jayanth-rajakumar/ledmat/docs/thumb_tutorial.png

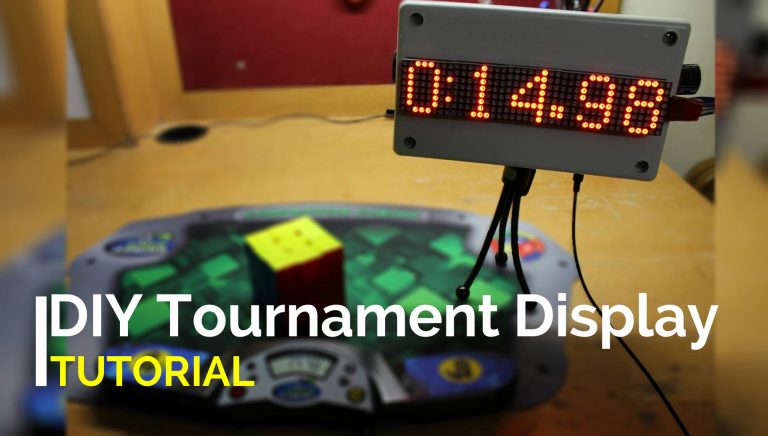
docs/thumb_tutorial.png
