jayanth-rajakumar/ledmat/docs/coverphoto.jpg

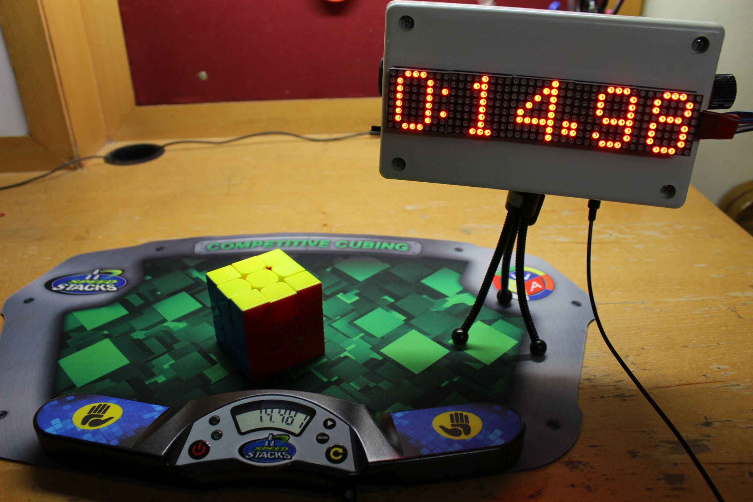
docs/coverphoto.jpg
