jayanth-rajakumar/ledmat/docs/blockdiagram.png

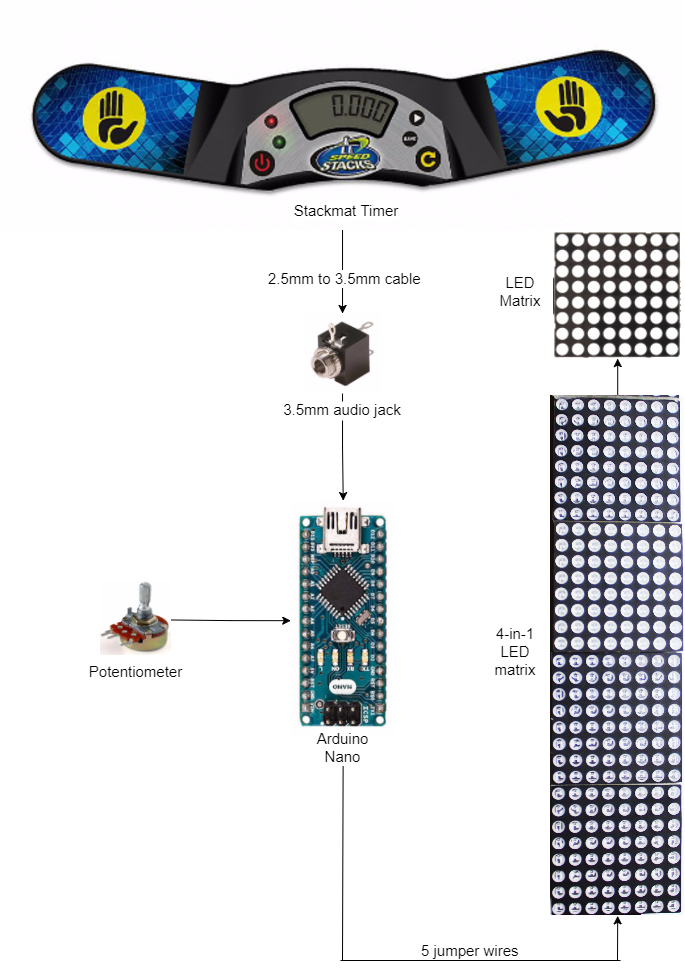
docs/blockdiagram.png
