jayanth-rajakumar/ledmat/docs/max7219.jpg

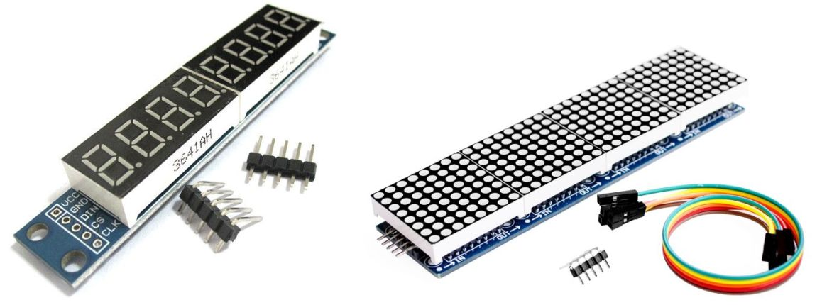
docs/max7219.jpg
