jayanth-rajakumar/ledmat/docs/oscilloscope.jpg

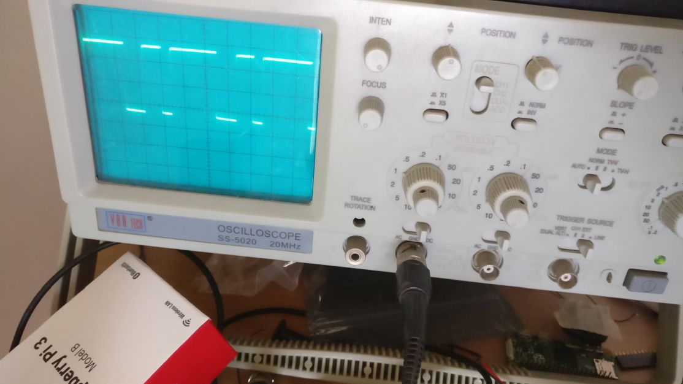
docs/oscilloscope.jpg
