jayanth-rajakumar/ledmat/docs/panorama.jpg

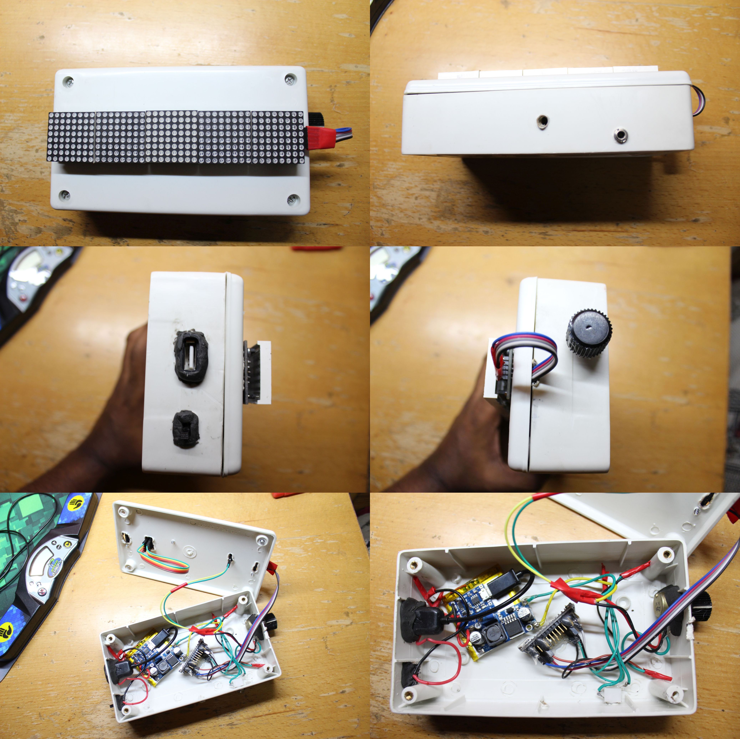
docs/panorama.jpg
