jayanth-rajakumar/ledmat/docs/psu.jpg

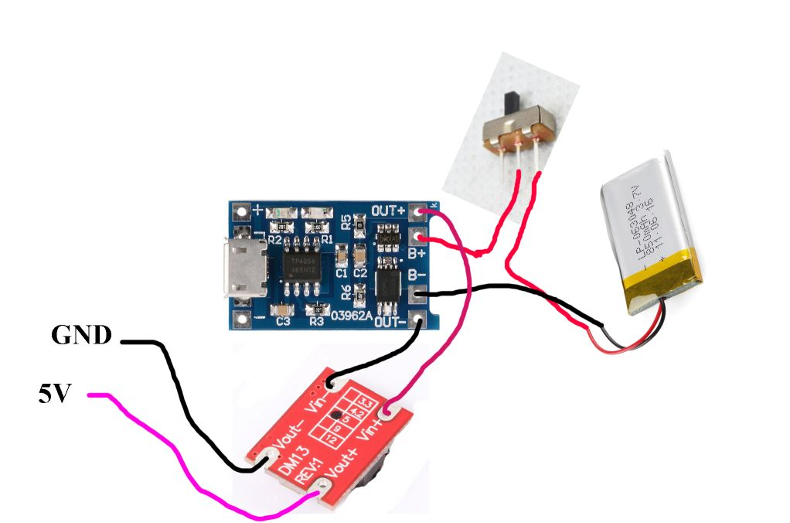
docs/psu.jpg
