jayanth-rajakumar/ledmat/img_prototype.jpg

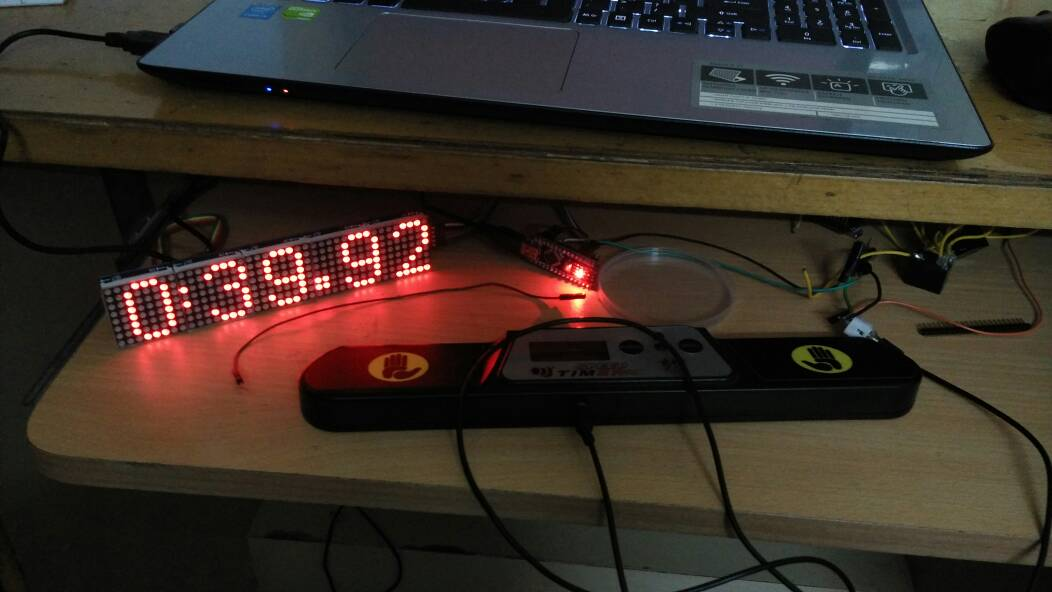
img_prototype.jpg
