jayanth-rajakumar/ledmat/(threads)

Thread 2 (2019-08-10):

Adding 0.91" Oled Display on back

SeijiMassui, 2019-08-10:
Hi Rajakumar, how are you!

Thanks for sharing your Ledmat project.

I had the opportunity to successfully assembly it.

And I added a rear display using an oled 0.91".

For this I had to delete some things in the original code to open free space enough to load the U8glib .

Modified code:
[ledmat-no-intensity-control_com_oled.ino.zip](https://github.com/jayanth-rajakumar/ledmat/files/3489057/ledmat-no-intensity-control_com_oled.ino.zip)

Working well:
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

And I made a kind of "box" to mount the display, made with 5 layers of 3mm translucent plastic (I cut on router cnc but can cut by laser) and spacers rings (I made on 3D printer):
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

Sketchup project of "box":
[Display_ABCM_2019_6.zip](https://github.com/jayanth-rajakumar/ledmat/files/3489086/Display_ABCM_2019_6.zip)

Well, that's it for now.
Thank you for your attention
Fabio Seiji Massui

Thread 3 (2021-06-12):

Troubleshooting

department-g33k, 2021-06-12:
I'm not terribly proficient in C#, and I'm having great difficult troubleshooting this (I'm building the display for my son).

When I connect my StackMat to the arduino and run  a timing cycle, I get no output on the LED matrix.  I've verified that the sleeve of the 3-pin connector to the stackmat is going to GND on the arduino, and that the tip is connected to D2.

I can verify that my LEDs and MD_Parola are working properly using their example code.

I see many "Serial.println()" functions, but I can't tell if I should be seeing the corresponding output in the Arduino serial monitor, or if those are used as part of the communication with the timer.

Frankly I'm lost as to how I might find out if my issue is on the display side, or that the MCU isn't detecting the timing signals from the Stackmat.

Any suggestions?

jayanth-rajakumar, 2021-06-16:
Hello! Github isn't notifying me about issues so I just saw this. I do apologize for the terrible state of the code, I would definitely do it much differently if I was doing it today. Unfortunately, I no longer have the hardware with me so I can't help you out too much with debugging this.

I was about to suggest using the Software Serial library with inverted logic instead of all the messy hardcoded decoding, but it looks like you've figured that out yourself. I actually tried that years ago, but the performance with my existing code seemed to be better. How is your setup working right now?
