jayanth-rajakumar/ledmat/ledmat-no-intensity-control/ledmat-no-intensity-control.ino

#include <MD_Parola.h>
#include <MD_MAX72xx.h>
#include <SPI.h>


#define MAX_DEVICES 5
#define CLK_PIN   13
#define DATA_PIN  11
#define CS_PIN    10


MD_Parola P = MD_Parola(CS_PIN, MAX_DEVICES);

MD_MAX72XX::fontType_t xantofont[] PROGMEM = {
  0,    // 0 - 'Empty Cell'
  5, 62, 91, 79, 91, 62,    // 1 - 'Sad Smiley'
  5, 62, 107, 79, 107, 62,    // 2 - 'Happy Smiley'
  5, 28, 62, 124, 62, 28,   // 3 - 'Heart'
  5, 24, 60, 126, 60, 24,   // 4 - 'Diamond'
  5, 28, 87, 125, 87, 28,   // 5 - 'Clubs'
  5, 28, 94, 127, 94, 28,   // 6 - 'Spades'
  4, 0, 24, 60, 24,   // 7 - 'Bullet Point'
  5, 255, 231, 195, 231, 255,   // 8 - 'Rev Bullet Point'
  4, 0, 24, 36, 24,   // 9 - 'Hollow Bullet Point'
  5, 255, 231, 219, 231, 255,   // 10 - 'Rev Hollow BP'
  5, 48, 72, 58, 6, 14,   // 11 - 'Male'
  5, 38, 41, 121, 41, 38,   // 12 - 'Female'
  5, 64, 127, 5, 5, 7,    // 13 - 'Music Note 1'
  5, 64, 127, 5, 37, 63,    // 14 - 'Music Note 2'
  5, 90, 60, 231, 60, 90,   // 15 - 'Snowflake'
  5, 127, 62, 28, 28, 8,    // 16 - 'Right Pointer'
  5, 8, 28, 28, 62, 127,    // 17 - 'Left Pointer'
  5, 20, 34, 127, 34, 20,   // 18 - 'UpDown Arrows'
  5, 95, 95, 0, 95, 95,   // 19 - 'Double Exclamation'
  5, 6, 9, 127, 1, 127,   // 20 - 'Paragraph Mark'
  4, 102, 137, 149, 106,    // 21 - 'Section Mark'
  5, 96, 96, 96, 96, 96,    // 22 - 'Double Underline'
  5, 148, 162, 255, 162, 148,   // 23 - 'UpDown Underlined'
  5, 8, 4, 126, 4, 8,   // 24 - 'Up Arrow'
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
  5, 16, 16, 16, 16, 255,   // 179 - 'Right T'
  5, 20, 20, 20, 20, 255,   // 180 - 'Right T double H'
  5, 16, 16, 255, 0, 255,   // 181 - 'Right T double V'
  5, 16, 16, 240, 16, 240,    // 182 - 'Top Right double V'
  5, 20, 20, 20, 20, 252,   // 183 - 'Top Right double H'
  5, 20, 20, 247, 0, 255,   // 184 - 'Right T double all'
  5, 0, 0, 255, 0, 255,   // 185 - 'Right side double'
  5, 20, 20, 244, 4, 252,   // 186 - 'Top Right double'
  5, 20, 20, 23, 16, 31,    // 187 - 'Bot Right double'
  5, 16, 16, 31, 16, 31,    // 188 - 'Bot Right double V'
  5, 20, 20, 20, 20, 31,    // 189 - 'Bot Right double H'
  5, 16, 16, 16, 16, 240,   // 190 - 'Top Right'
  5, 0, 0, 0, 31, 16,   // 191 - 'Bot Left'
  5, 16, 16, 16, 31, 16,    // 192 - 'Bot T'
  5, 16, 16, 16, 240, 16,   // 193 - 'Top T'
  5, 0, 0, 0, 255, 16,    // 194 - 'Left T'
  5, 16, 16, 16, 16, 16,    // 195 - 'Top side'
  5, 16, 16, 16, 255, 16,   // 196 - 'Center +'
  5, 0, 0, 0, 255, 20,    // 197 - 'Left side double H'
  5, 0, 0, 255, 0, 255,   // 198 - 'Left side double'
  5, 0, 0, 31, 16, 23,    // 199 - 'Bot Left double V'
  5, 0, 0, 252, 4, 244,   // 200 - 'Top Left double V'
  5, 20, 20, 23, 16, 23,    // 201 - 'Bot T double'
  5, 20, 20, 244, 4, 244,   // 202 - 'Top T double'
  5, 0, 0, 255, 0, 247,   // 203 - 'Left Side double spl'
  5, 20, 20, 20, 20, 20,    // 204 - 'Center double'
  5, 20, 20, 247, 0, 247,   // 205 - 'Center + double'
  5, 20, 20, 20, 23, 20,    // 206 - 'Bot T double H'
  5, 16, 16, 31, 16, 31,    // 207 - 'Bot Right double V'
  5, 20, 20, 20, 244, 20,   // 208 - 'Top T double H'
  5, 16, 16, 240, 16, 240,    // 209 - 'Top Right double V'
  5, 0, 0, 31, 16, 31,    // 210 - 'Bot Left double V'
  5, 0, 0, 0, 31, 20,   // 211 - 'Bot Right double H'
  5, 0, 0, 0, 252, 20,    // 212 - 'Top Right double H'
  5, 0, 0, 240, 16, 240,    // 213 - 'Top Right double V'
  5, 16, 16, 255, 16, 255,    // 214 - 'Center + double V'
  5, 20, 20, 20, 255, 20,   // 215 - 'Center + double H'
  5, 16, 16, 16, 16, 31,    // 216 - 'Bot Right'
  5, 0, 0, 0, 240, 16,    // 217 - 'Top Left'
  5, 255, 255, 255, 255, 255,   // 218 - 'Full Block'
  5, 240, 240, 240, 240, 240,   // 219 - 'Half Block Bottom'
  3, 255, 255, 255,   // 220 - 'Half Block LHS'
  5, 0, 0, 0, 255, 255,   // 221 - 'Half Block RHS'
  5, 15, 15, 15, 15, 15,    // 222 - 'Half Block Top'
  5, 56, 68, 68, 56, 68,    // 223 - 'Alpha'
  5, 124, 42, 42, 62, 20,   // 224 - 'Beta'
  5, 126, 2, 2, 6, 6,   // 225 - 'Gamma'
  5, 2, 126, 2, 126, 2,   // 226 - 'Pi'
  5, 99, 85, 73, 65, 99,    // 227 - 'Sigma'
  5, 56, 68, 68, 60, 4,   // 228 - 'Theta'
  5, 64, 126, 32, 30, 32,   // 229 - 'mu'
  5, 6, 2, 126, 2, 2,   // 230 - 'Tau'
  5, 153, 165, 231, 165, 153,   // 231
  5, 28, 42, 73, 42, 28,    // 232
  5, 76, 114, 1, 114, 76,   // 233
  5, 48, 74, 77, 77, 48,    // 234
  5, 48, 72, 120, 72, 48,   // 235
  5, 188, 98, 90, 70, 61,   // 236 - 'Zero Slashed'
  4, 62, 73, 73, 73,    // 237
  5, 126, 1, 1, 1, 126,   // 238
  5, 42, 42, 42, 42, 42,    // 239 - '3 Bar Equals'
  5, 68, 68, 95, 68, 68,    // 240 - '+/-'
  5, 64, 81, 74, 68, 64,    // 241 - '>='
  5, 64, 68, 74, 81, 64,    // 242 - '<='
  5, 0, 0, 255, 1, 3,   // 243 - 'Top of Integral'
  3, 224, 128, 255,   // 244 - 'Bot of Integral'
  5, 8, 8, 107, 107, 8,   // 245 - 'Divide'
  5, 54, 18, 54, 36, 54,    // 246 - 'Wavy ='
  5, 6, 15, 9, 15, 6,   // 247 - 'Degree'
  4, 0, 0, 24, 24,    // 248 - 'Math Product'
  4, 0, 0, 16, 16,    // 249 - 'Short Dash'
  5, 48, 64, 255, 1, 1,   // 250 - 'Square Root'
  5, 0, 31, 1, 1, 30,   // 251 - 'Superscript n'
  5, 0, 25, 29, 23, 18,   // 252 - 'Superscript 2'
  5, 0, 60, 60, 60, 60,   // 253 - 'Centered Square'
  5, 255, 129, 129, 129, 255,   // 254 - 'Full Frame'
  5, 255, 255, 255, 255, 255,   // 255 - 'Full Block'
};

int serial_in = 2,pulse;
long temp;
bool begin_=1;
volatile long duration=0,m1,m2;
volatile int i=0,arr[90],toggle=0;
String packet="",current_time="",packet_="";

void getbytes(String strbyte);
int twopwr(int);



void setup()
{
 P.begin();
 //Change 0 to any 0-15 integer to fix brightness
  P.setIntensity(0);
  P.setFont(xantofont);

 
  Serial.begin(115200);
  pinMode(serial_in, INPUT);
  digitalWrite(serial_in,HIGH);

     while(1)
   
  {
    temp=pulseIn(serial_in, LOW);
    if(temp>56000 and temp<66000)
    break;
  }
  
}

void loop() {

  i=0,toggle=0;
  for(int k=0;k<90;k++)
  arr[k]=0;
  long test_=millis();

  /*
  attachInterrupt(digitalPinToInterrupt(serial_in), isr, CHANGE);
  while(toggle==0)
  {
    if(millis()-test_>90)
    {
      P.displayText("-:--.--", PA_LEFT, 0, 0, PA_PRINT, PA_SCROLL_UP);
       P.displayAnimate();
    }
  }
  detachInterrupt(digitalPinToInterrupt(serial_in));
  */

  delayMicroseconds(416);
  
            
            for(int lx=0;lx<30;lx++)
            {
              arr[lx]=digitalRead(serial_in);    
              delayMicroseconds(810);
            }
            
            arr[30]=digitalRead(serial_in);           
            delayMicroseconds(810);
            
            for(int lx=31;lx<90;lx++)
            {
              arr[lx]=digitalRead(serial_in);    
              delayMicroseconds(810);
            }
            
            
            
            
  for(int k=0;k<90;k++)
  {
   Serial.print(String(arr[k]));
  }
  
  
  Serial.print("\n");
  pulse=1;packet="";current_time="";
  /*
  for(int k=1;arr[k]!=0;k++)
  {
    for(int j=0;j<round((float)arr[k]/828);j++)
    {
      packet+=String(!pulse);
    }
    pulse=!pulse;
  }
  */
  packet="";
  for(int k=0;k<90;k++)
  {
    if(arr[k]==0){
      packet+="1";
    }
    else
    packet+="0";
    }
  //  Serial.println(packet);
 for(int k=1;k<=5;k++)
 getbytes(packet.substring(k*10+1,(k+1)*10-1));

 current_time=current_time.substring(0,1)+':'+current_time.substring(1,3)+'.'+current_time.substring(3,5);
  
  char charbuf[10];
  current_time.toCharArray(charbuf,10);

  if(isDigit(charbuf[0]) and isDigit(charbuf[6]) and isDigit(charbuf[2]) and isDigit(charbuf[3]) and isDigit(charbuf[5]))
  {
    P.displayText(charbuf, PA_LEFT, 0, 0, PA_PRINT, PA_SCROLL_UP);
    P.displayAnimate(); 
  }
  else
  {
   //Hack to resolve last seconds on QJ Timer. TODO: Improve timing of digitalRead to fix this

   charbuf[5]=qj_fix(charbuf[5]);
   charbuf[6]=qj_fix(charbuf[6]);

        if(isDigit(charbuf[0]) and isDigit(charbuf[6]) and isDigit(charbuf[2]) and isDigit(charbuf[3]) and isDigit(charbuf[5]))
        {
          P.displayText(charbuf, PA_LEFT, 0, 0, PA_PRINT, PA_SCROLL_UP);
          P.displayAnimate(); 
        }
    
   
  }

 
  long test=millis();
  while(digitalRead(serial_in)==0)
  {
    if(millis()-test>90)
    {
      P.displayText("-:--.--", PA_LEFT, 0, 0, PA_PRINT, PA_SCROLL_UP);
       P.displayAnimate();
    }
  }
  
}

void isr()
{
  m1=micros();

 if(m1-m2>58000 and begin_==true)
  {
    Serial.println("Start");begin_=false;
    
  }
  else
  {
     arr[i]=m1-m2;
    if(i>5 and round((float)arr[i]/750)==4 and round((float)arr[i-1]/750)==2 and round((float)arr[i-2]/750)==1 and round((float)arr[i-3]/750)==1 and round((float)arr[i-4]/750)==1 and round((float)arr[i-5]/750)==1)
   {
    
   // Serial.println();
    m2=micros();
    toggle=1;
    return;
   }
   
   // Serial.print(String(arr[i])+"-");
    i++;
  }
  m2=micros();

}

void getbytes(String strbyte)
{

  int digit=0;
  for(int k=0;k<8;k++)
  {
   if(strbyte[k]=='1')
   {
    digit+=twopwr(k);
      
   }
  }

  char c=digit;
 current_time+=String(c);
  
}

//Returns 2 raised to the specified integer. Required because pow() from math.h has rounding errors.
int twopwr(int a)
{
  int out=1;
  for(int l=0;l<a;l++)
  out=out*2;

  return out;
}

char qj_fix(char ch)
{
  switch(ch)
  {
    case '`':
    return '0';
    break;

    case 'b':
    return '1';
    break;

    case 'd':
    return '2';
    break;

    case 'f':
    return '3';
    break;

    case 'h':
    return '4';
    break;

    case 'j':
    return '5';
    break;

    case 'l':
    return '6';
    break;

    case 'n':
    return '7';
    break;

    case 'p':
    return '8';
    break;

    case 'r':
    return '9';
    break;

    
  }
}
