jayanth-rajakumar/ledmat/(commit log)

2017-06-08 Added arduino sketch
2017-06-08 Uploaded prototype image
2017-06-10 Fully working version that doesn't skip every other packet
    [ledmat.ino]
2017-06-13 Fixed font issue and added back all characters
    [ledmat.ino]
2017-06-25 Removed serial output. TODO: fix last packet being skipped until hands are lifted
    [ledmat.ino]
2017-06-30 Added temporary hack to fix delay of last packet until hands are lifted (on G4 Pro). Added intensity control by 1K pot
    [ledmat.ino]
